EmilAltmann/robotik/documentaion/LARS_schematic.pdf

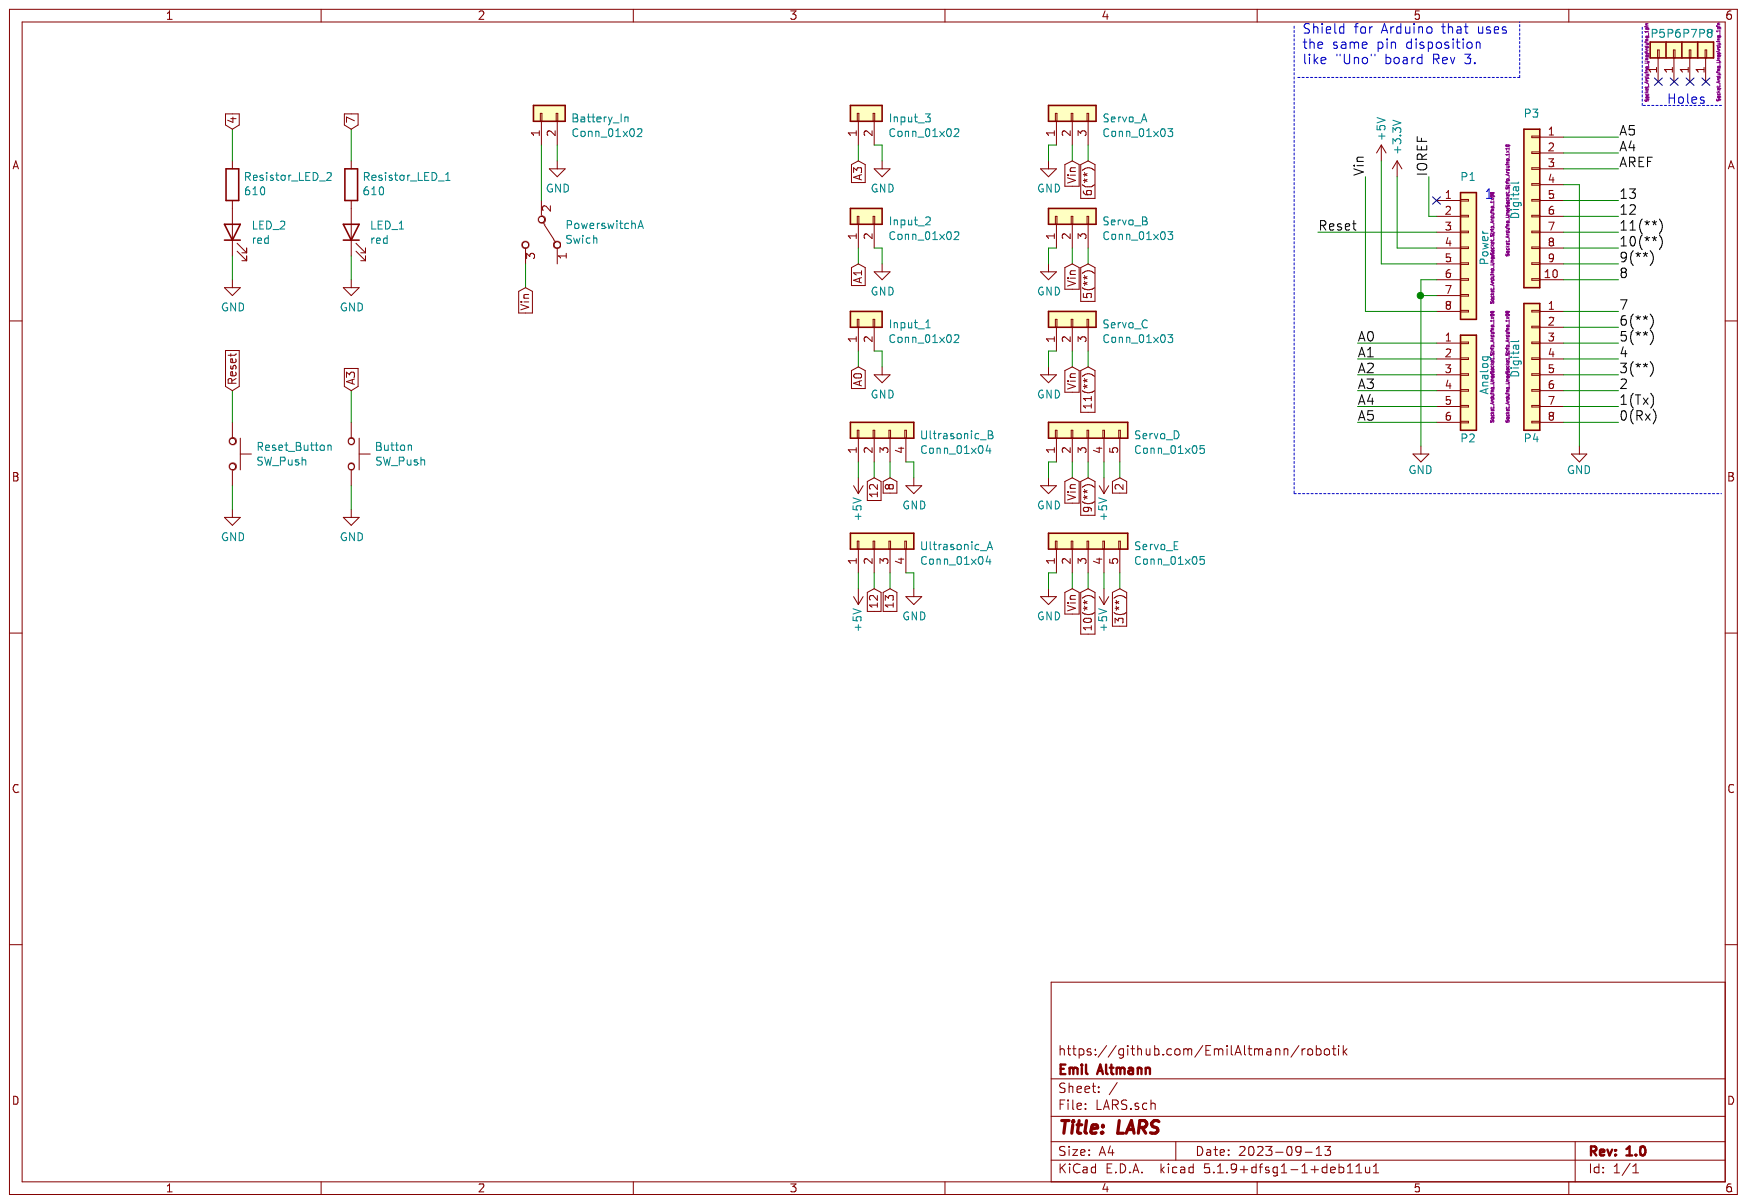
[picture p8: page 1]
