EmilAltmann/robotik/documentaion/LARS/LARS_schematic.pdf

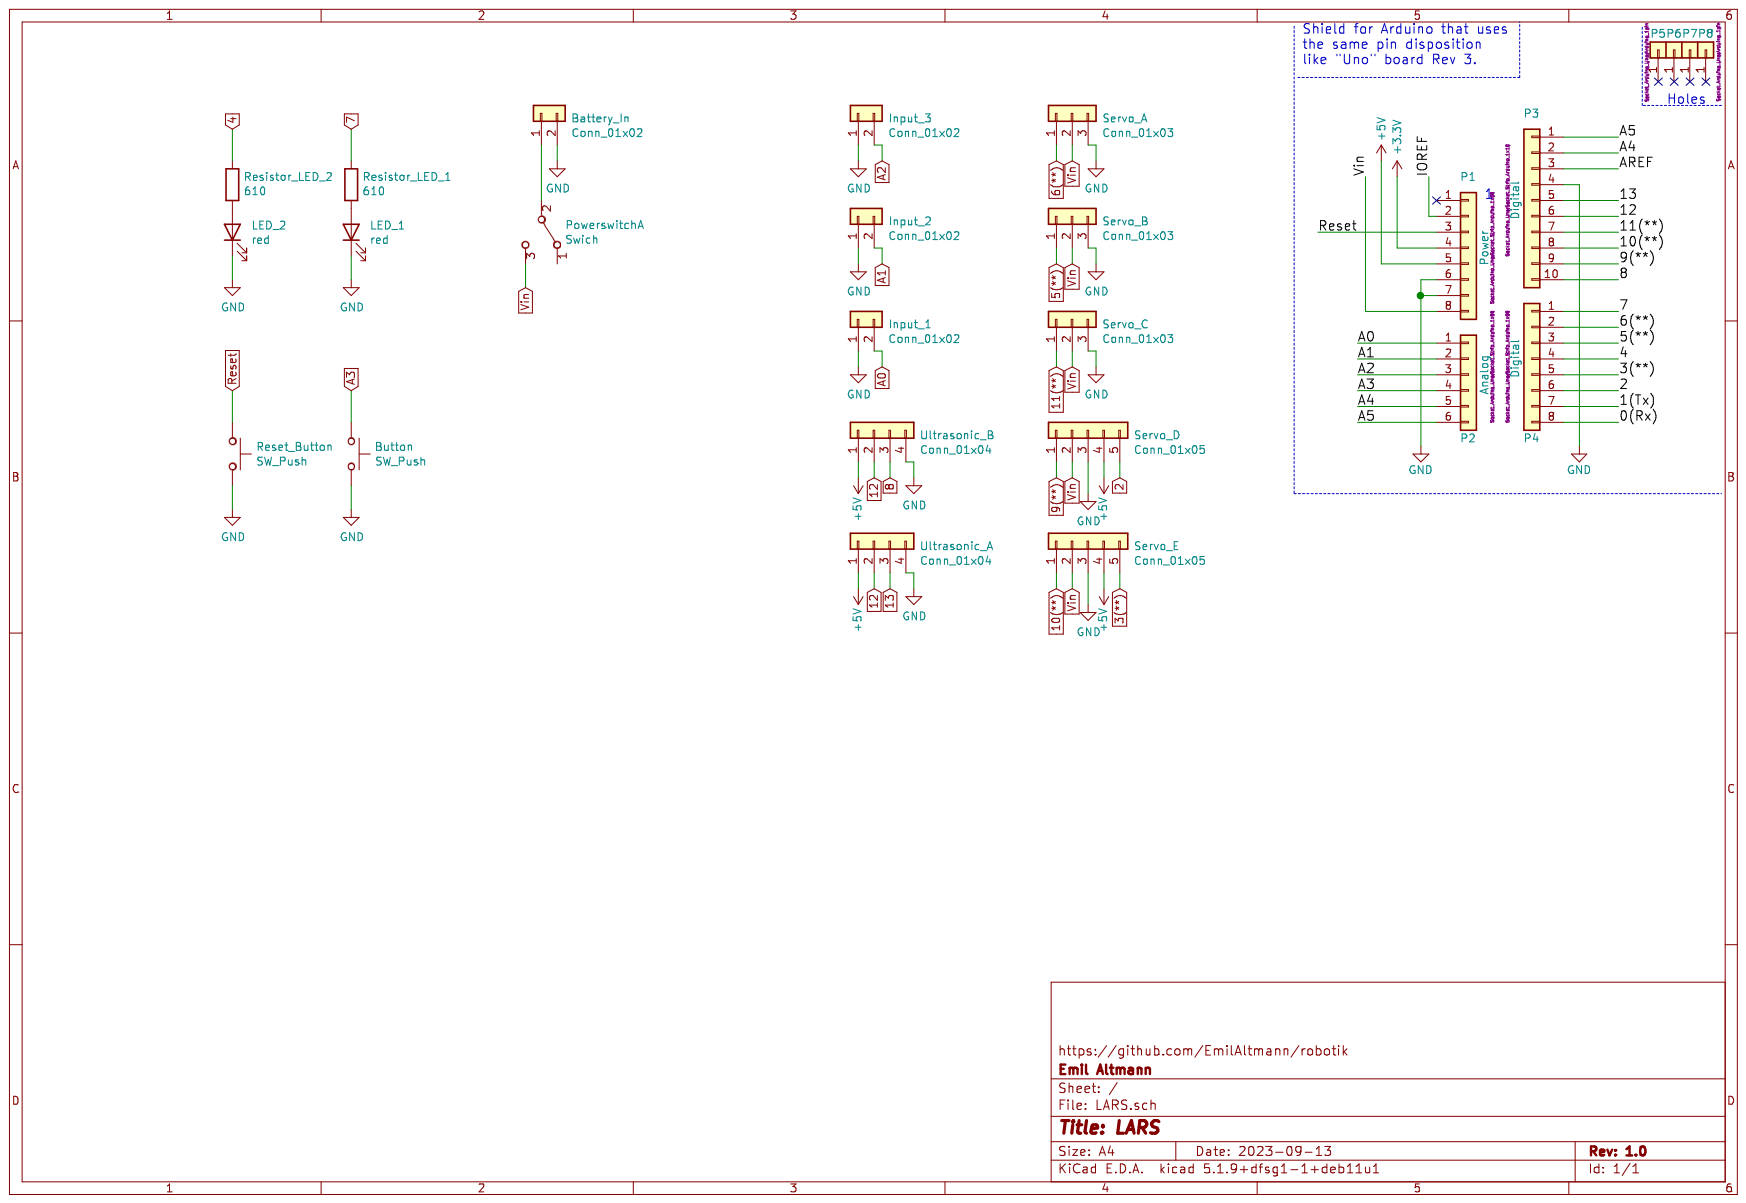
[picture p9: page 1]
