EmilAltmann/robotik/documentaion/LARS/prototype_schematic.pdf

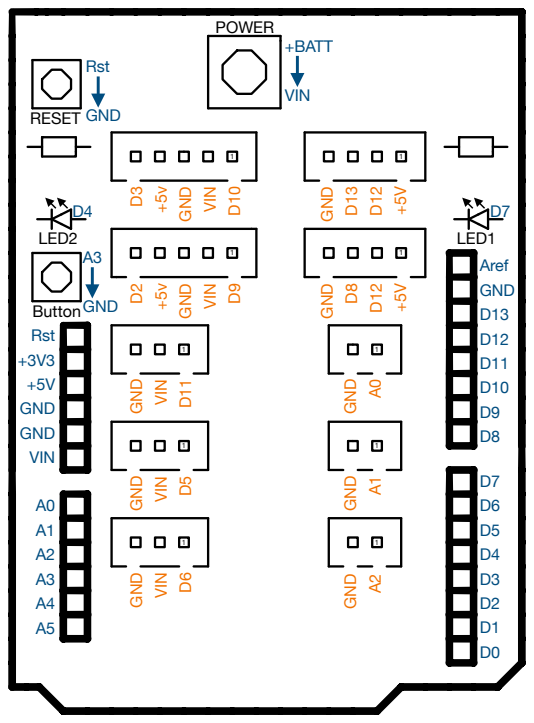
[picture p10: page 1]
