EmilAltmann/robotik/documentaion/LARS/LARS_PCB.pdf

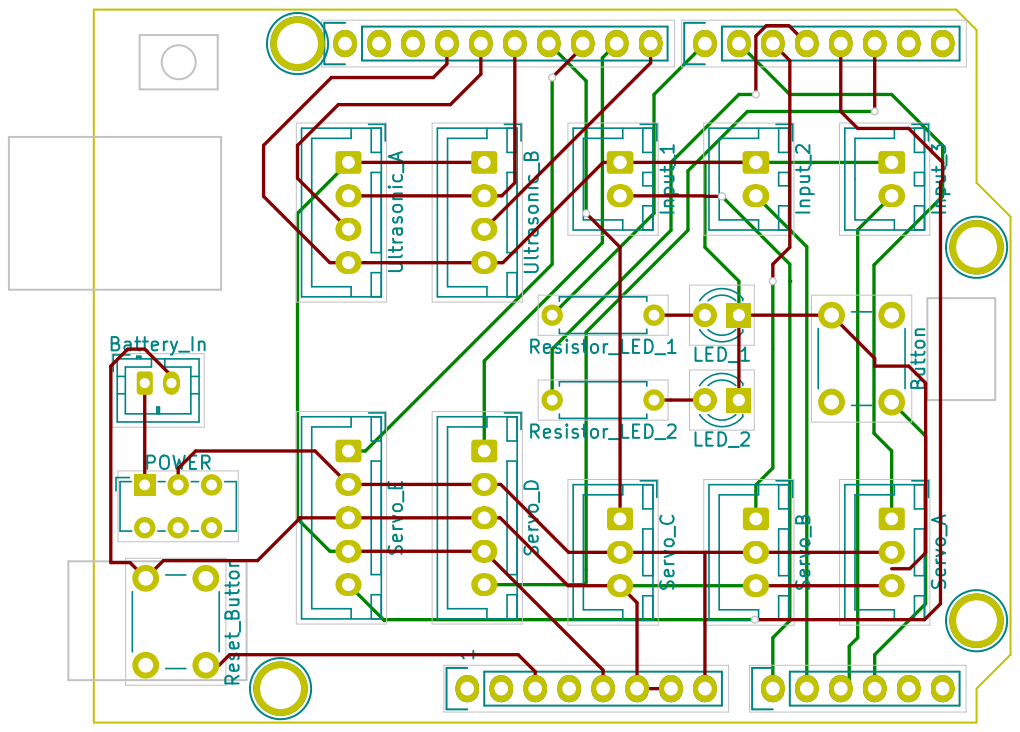
[picture p11: page 1]
