EmilAltmann/robotik/documentaion/LARS/KiCAD/LARS.kicad_pcb

## KiCad design documentaion/LARS/KiCAD/LARS.kicad_pcb (2023-09-28)

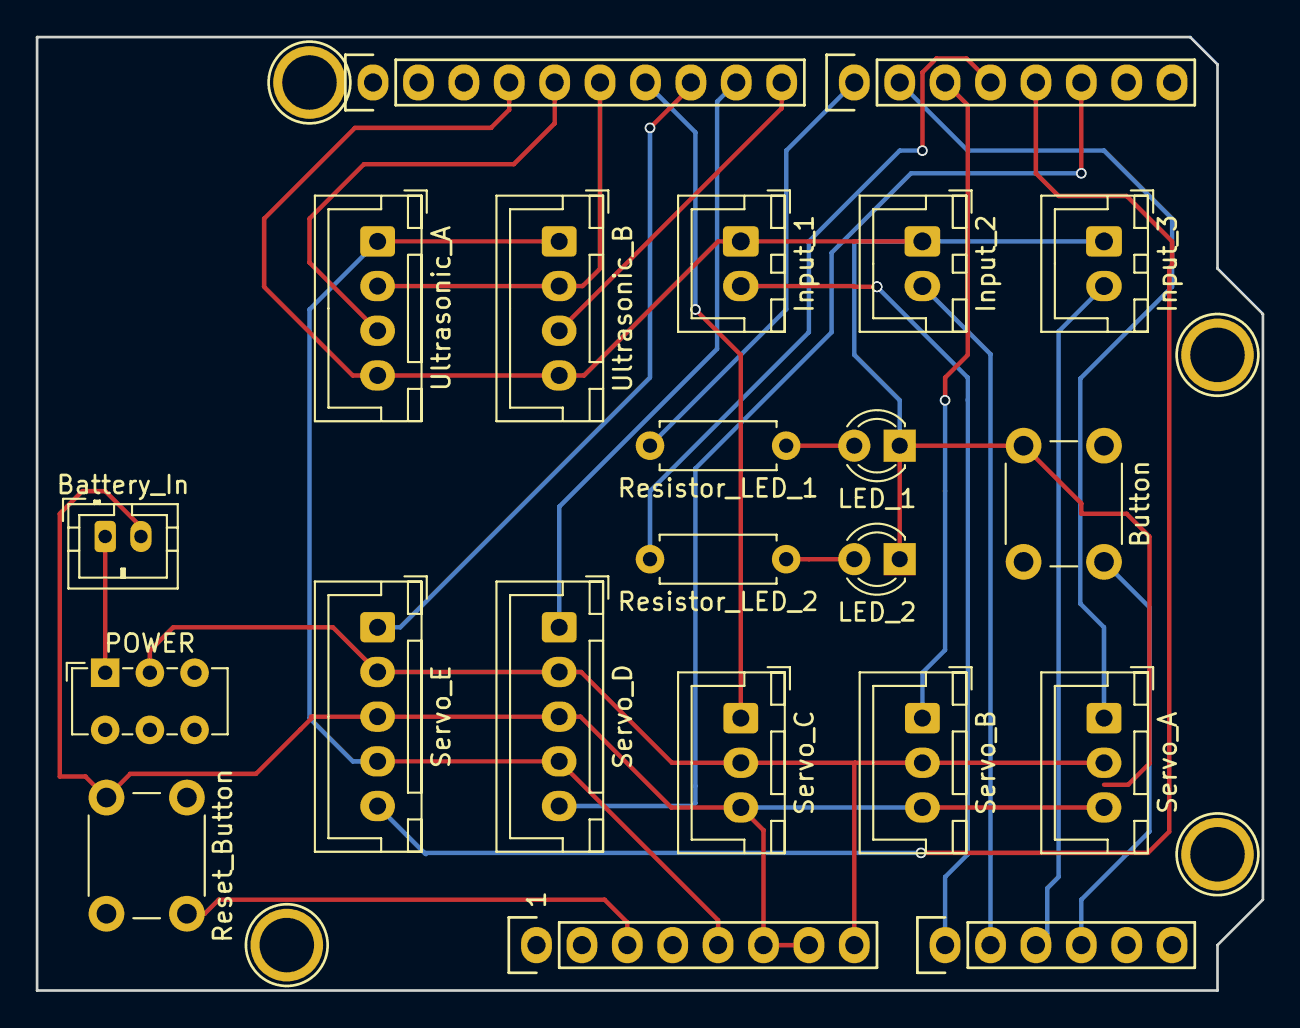
[picture p12: board LARS.kicad_pcb from above]

Board: 2 copper layers, 68.6 x 53.3 mm, 26 parts (0 on the bottom side), 23 nets.

Parts:
Battery_In: Conn_01x02; JST_PH_B2B-PH-K_1x02_P2.00mm_Vertical
Button: SW_Push; SW_PUSH_6mm_H4.3mm
Input_1, Input_2, Input_3: Conn_01x02; JST_XH_B2B-XH-A_1x02_P2.50mm_Vertical
LED_1, LED_2: red; LED_D3.0mm
P1: Power; Socket_Strip_Arduino_1x08
P2: Analog; Socket_Strip_Arduino_1x06
P3: Digital; Socket_Strip_Arduino_1x10
P4: Digital; Socket_Strip_Arduino_1x08
P5, P6, P7, P8: CONN_01X01; Arduino_1pin
POWER: SW_DPST_x2; SW_E-Switch_EG1271_DPDT
Reset_Button: SW_Push; SW_PUSH_6mm_H4.3mm
Resistor_LED_1, Resistor_LED_2: 610; R_Axial_DIN0207_L6.3mm_D2.5mm_P7.62mm_Horizontal
Servo_A: Conn_01x03; JST_XH_B3B-XH-A_1x03_P2.50mm_Vertical
Servo_B: Conn_01x03; JST_XH_B3B-XH-A_1x03_P2.50mm_Vertical
Servo_C: Conn_01x03; JST_XH_B3B-XH-A_1x03_P2.50mm_Vertical
Servo_D: Conn_01x05; JST_XH_B5B-XH-A_1x05_P2.50mm_Vertical
Servo_E: Conn_01x05; JST_XH_B5B-XH-A_1x05_P2.50mm_Vertical
Ultrasonic_A: Conn_01x04; JST_XH_B4B-XH-A_1x04_P2.50mm_Vertical
Ultrasonic_B: Conn_01x04; JST_XH_B4B-XH-A_1x04_P2.50mm_Vertical

Connections:
2: P4.6, Servo_D.5
3(**): P4.5, Servo_E.5
4: P4.4, Resistor_LED_2.2
5(**): P4.3, Servo_B.1
6(**): P4.2, Servo_A.1
7: P4.1, Resistor_LED_1.2
8: P3.10, Ultrasonic_B.3
9(**): P3.9, Servo_D.1
10(**): P3.8, Servo_E.1
11(**): P3.7, Servo_C.1
12: P3.6, Ultrasonic_A.2, Ultrasonic_B.2
13: P3.5, Ultrasonic_A.3
+5V: P1.5, Servo_D.4, Servo_E.4, Ultrasonic_A.1, Ultrasonic_B.1
A0: Input_1.2, P2.1
A1: Input_2.2, P2.2
A2: Input_3.2, P2.3
A3: Button.1, P2.4
GND: Battery_In.2, Button.2, Input_1.1, Input_2.1, Input_3.1, LED_1.1, LED_2.1, P1.6, P1.7, P3.4, Reset_Button.2, Servo_A.3, Servo_B.3, Servo_C.3, Servo_D.3, Servo_E.3, Ultrasonic_A.4, Ultrasonic_B.4
unnamed: Battery_In.1, POWER.1
unnamed: LED_1.2, Resistor_LED_1.1
unnamed: LED_2.2, Resistor_LED_2.1
Reset: P1.3, Reset_Button.1
Vin: P1.8, POWER.2, Servo_A.2, Servo_B.2, Servo_C.2, Servo_D.2, Servo_E.2
