EmilAltmann/robotik/(commit log)

2023-09-15 added simple schematic
2023-09-28 moved files
    [LARS.kicad_pcb, LARS.sch]
2023-09-28 Added info about the KiCAD PCB design
